RoadrunnerVmax/uaefi/boards/uaefi-e2/board/uaefi-e2-bom-jlcexport.xls

Comment | topDesignator | bottomDesignator | Footprint | JLCPCB Part #
1u |  |  | C0603 | C15849
AD8628 |  |  | TSOT23-5 | C29309
YELLOW_LED |  |  | LED0603 | C165983
MAX9924UAUB+T |  |  | MSOP10 | C5145181
100n |  |  | C0603 | C14663
1u |  |  | C0603 | C14664
750 |  |  | R0603 | C23241
47u |  |  | C1206 | C96123
BAS416 |  |  | SOD-323 | C968040
SN74LVC1G06DCKR |  |  | SC-70-5 | C7828
10u |  |  | C0603 | C96446
TJA1051T/3/1J |  |  | SO8 | C38695
100k |  |  | R0402 | C25741
33k |  |  | R0402 | C25779
2.2k |  |  | R0402 | C25879
10k |  |  | R0603-4 | C29718
PSM712-LF |  |  | SOT-23 | C5180294
680p |  |  | C0603 | C1630
SS34 |  |  | SMA | C8678
100n |  |  | C0402 | C307331
AO3400A |  |  | SOT-23 | C20917
10n |  |  | C0402 | C15195
27k |  |  | R0402 | C25771
20MHz |  |  | SMD5032 | C112566
VNLD5090 |  |  | SO-8 | C222209
1N4148WS |  |  | SOD-323 | C2128
10u |  |  | C0805 | C15850
5.6k |  |  | R0603 | C23189
0 |  |  | R2512 | C25469
470R@100MHz |  |  | L_0603_1608Metric | C97853
GREEN_LED |  |  | LED0603 | C965804
WAS3157B-6 |  |  | SOT-363 | C213161
2.2u |  |  | C0402 | C12530
STM32F042K6T7 |  |  | LQFP-32 | C1337340
LMR14020 |  |  | SOP8 | C187824
32.768kHz |  |  | SMD2012 | C99009
TF-014-H16 |  |  | SMD | C125814
4.7k |  |  | R0402 | C25900
1n |  |  | C0603 | C1588
P6SMB6.8CA |  |  | SMB | C78395
BLUE_LED |  |  | LED0603 | C497940
LED-RED-0603 |  |  | LED-0603 | C2286
1 |  |  | R0402 | C2770750
NLCV32T-2R2M-EF |  |  | L1210 | C250227
MWSA0503S-100MT |  |  | MWSA0503 | C408412
1k |  |  | R0402 | C11702
LPS22 |  |  | HLGA-10L | C2827824
74AHC1G02 |  |  | SOT23-5 | C7463
12k |  |  | R0402 | C25752
TLS115B0EJXUMA1 |  |  | PG-DSO-8 | C3747428
1u |  |  | C0402 | C52923
10k |  |  | R0603 | C98220
330p |  |  | C0402 | C13533
100n |  |  | C0402 | C1525
0 |  |  | R0603 | C21189
MHT136UGCT |  |  | LED0402 | C434447
5569-20A2 |  |  | 2x10P24.2mmFemalepin4.2mm | C2845795
SMCJ30A |  |  | SMC | C310046
22 |  |  | R0603 | C23345
5569-18A2 |  |  | 2x9P24.2mmFemale4.2mm9Right-Angle | C725776
47u |  |  | C0603 | C140782
22u |  |  | C0603 | C59461
USB_C |  |  | USB_C | C2927038
12p |  |  | C0402 | C1547
100 |  |  | R0603 | C22775
39301160 |  |  | 02x08_4.2mm | C5355564
68k |  |  | R0402 | C36871
10n |  |  | C0603 | C57112
BTN |  |  | SMD-2_2.9x3.9x1.7 | C455280
SMD1206B035TF/16 |  |  | R1206 | C269114
B5819W |  |  | SOD-123 | C8598
510 |  |  | R0402 | C25123
MCP6004 |  |  | TSSOP14 | C50282
3.3k |  |  | R0402 | C25890
LP2981-33DBVR |  |  | SOT-23-5 | C129997
5.1k |  |  | R0402 | C25905
470k |  |  | R0402 | C137976
4.7u |  |  | C0402 | C23733
680k |  |  | R0402 | C4131
Fuse |  |  | Fuse_1206_3216Metric_Pad1.42x1.75mm_HandSolder | C182446
3.3n |  |  | C0402 | C107028
47 |  |  | R0402 | C25118
REF3033 |  |  | SOT-23 | C36658
LMV321IDBVR |  |  | SOT23-5 | C7972
STM32F407VGT6 |  |  | LQFP100 | C12345
TLE9201SG |  |  | Infineon_PG-DSO-12-11 | C2653438
33k |  |  | R0603 | C4216
4.7k |  |  | R0603-4 | C66697
PESD1CAN |  |  | SOT-23 | C343993
SN74LXCH8T245PWR |  |  | TSSOP-24 | C2918963
TLV3202AIDR |  |  | SO8 | C129325
BAT54S |  |  | SOT-23 | C47546
BLM18AG601SN1D |  |  | L0603 | C19330
nSMD050-24V |  |  | SMD1206 | C70076
50mA |  |  | Fuse_0603_1608Metric | C369141
4.7u |  |  | C0603 | C19666
10 |  |  | R0402 | C25077
61.9 |  |  | R0603 | C321964
AO3401A |  |  | SOT-23 | C15127
Conn_01x06 |  |  | PinHeader_1x06_P2.54mm_Vertical | C37208
47p |  |  | C0402 | C1567
10k |  |  | R0805 | C17414
22k |  |  | R0402 | C25768
470n |  |  | C0402 | C47339
6.8k |  |  | R0402 | C25917
10k |  |  | R0402 | C60490
LDL1117S33R |  |  | SOT-223 | C6186
VNN7NV04PTR-E |  |  | SOT-223 | C501115
1n |  |  | C0402 | C1523
CR1220 |  |  | CR1220-2 | C70381
20k |  |  | R0402 | C25765
4.7k |  |  | R0603 | C23162
470 |  |  | R0603-4 | C25510
0 |  |  | R0402 | C17168
74LVC2G17GW,125 |  |  | SOT-363 | C80500
33n |  |  | C0402 | C106862
4.7k |  |  | R1206 | C17936
6.8k |  |  | R0603 | C23212
5569-08A2 |  |  | 2x4P2Tin4.2mmFemale4.2mm | C388760
SRV05-4-P-T7 |  |  | SOT23-6 | C85364
18p |  |  | C0402 | C1549
XC6206P332MR |  |  | SOT-23 | C5446
120 |  |  | R0603 | C22787
220p |  |  | C0402 | C1530
5569-06A2 |  |  | 2x3P24.2mm4.2mm3BrassPush-Pull | C19188572
